neomilium/utophuile/electronics/utophuile_i2c/utophuile_i2c_connector_serigraph.ods

GND | 12V |  | 5V | SDA | GND | SCL | GND
 |  | GND | 12V | K1 | K1
K4 | K4 | GND | 12V |  | K3 | K3 | K2 | K2
 |  |  |  |  |  |  |  |  | K1 = EV Arrivée K2 = EV Retour K3 = Pompe K4 = Réchauffeur
