neomilium/utophuile/electronics/utophuile_i2c/utophuile_i2c_bom.ods

Qty | Value | Device | Parts
1 |  | 78MXXS | IC1
3 |  | DS01 | S1, S2, S3
1 |  | PINHD-1X5 | JP1
6 | 1N4148 | 1N4148 | D1, D2, D3, D4, D5, D6
4 | 2K2 | R-EU_0207/10 | R5, R6, R7, R8
3 | 10K | R-EU_0207/10 | R9, R10, R11
4 | 15K | R-EU_0207/10 | R1, R2, R3, R4
1 | 18 1W | R-EU_0411/15 | R12
1 | 100n | C-EU050-025X075 | C1
1 | 1000µ 10V | CPOL-EUE3.5-10 | C2
1 | 1000µ 20V | CPOL-EUE3.5-10 | C3
4 | BC557 | BC557 | Q1, Q2, Q3, Q4
19 | BORN_VIS2 | BORN_VIS2 | J1, J2, J3, J4, J5, J6, J7, J8, J9, J10, J11, J12, J13, J14, J15, J16, J17, J19, J20
1 | PCF8574P | PCF8574P | U1
4 | RE030005 | RE030005 | K1, K2, K3, K4
