neomilium/utophuile/electronics/avr_mainboard/avr_mainboard_v004_bom.ods

Qty | Value | Device | Parts
1 |  | 10-XX | S1
1 |  | 22-05-7048-04 | J1
1 |  | LED3MM | LED1
2 |  | ML10L | ISP, JTAG
1 |  | PINHD-1X2 | JP2
1 |  | PINHD-1X3 | JP1
3 |  | PINHD-1X4 | ALIM, I2C, SERIE
4 |  | PINHD-1X10 | PA, PB, PC, PD
1 | 10K | R-EU_0207/10 | R2
1 | 16M | CRYTALHC49U-LM | Q1
1 | 24LC256P | 24LC256P | IC2
2 | 33p | C-EU050-024X044 | C1, C2
3 | 100n | C-EU050-025X075 | C3, C4, C5
1 | 220 | R-EU_0207/10 | R1
2 | 32768 | CRYTALTC26H | Q2, Q3
1 | BZW06_5V8 | BZW04XX | D1
1 | CR2032H | CR2032H | G1
1 | DS1307D | DS1307D | IC3
1 | MEGA32-P | MEGA32-P | IC1
