neomilium/utophuile/electronics/utophuile_shield/utophuile_shield_v0_2_bom.ods

Qty | Value | Device | Parts
3 |  | AK500/2 | X1, X2, X3
1 |  | AK500/4 | X4
4 |  | PINHD-1X2_2.54-90° | LED_GREEN, LED_ORANGE, LED_RED, SWITCH
1 |  | PINHD-1X4 | ALIM
2 |  | PINHD-1X4_2.54-90° | BUZZER, UART
4 |  | PINHD-1X10 | PA, PB, PC, PD
2 |  | R-EU_0207/10 | R3, R7
1 | 0 | R-EU_0207/10 | R2
1 | 1K5 | R-EU_0207/10 | R1
1 | 2N2222A | 2N2222A | Q1
1 | 15K | R-EU_0207/10 | R12
1 | 47K | R-EU_0207/10 | R15
5 | 100K | R-EU_0207/10 | R11, R13, R14, R16, R17
3 | 100K | R-TRIMMT93YB | R8, R9, R10
2 | 100n | C-EU050-025X075 | C3, C4
3 | 150 | R-EU_0207/10 | R4, R5, R6
1 | 220µ | CPOL-EUE3.5-10 | C2
1 | 470µ | CPOL-EUE3.5-10 | C1
2 | BZW06_5V8 | BZW04XX | D1, D2
1 | LM324N | LM324N | IC1
