neomilium/utophuile/electronics/utophuile_i2c/utophuile_i2c_brd.pdf

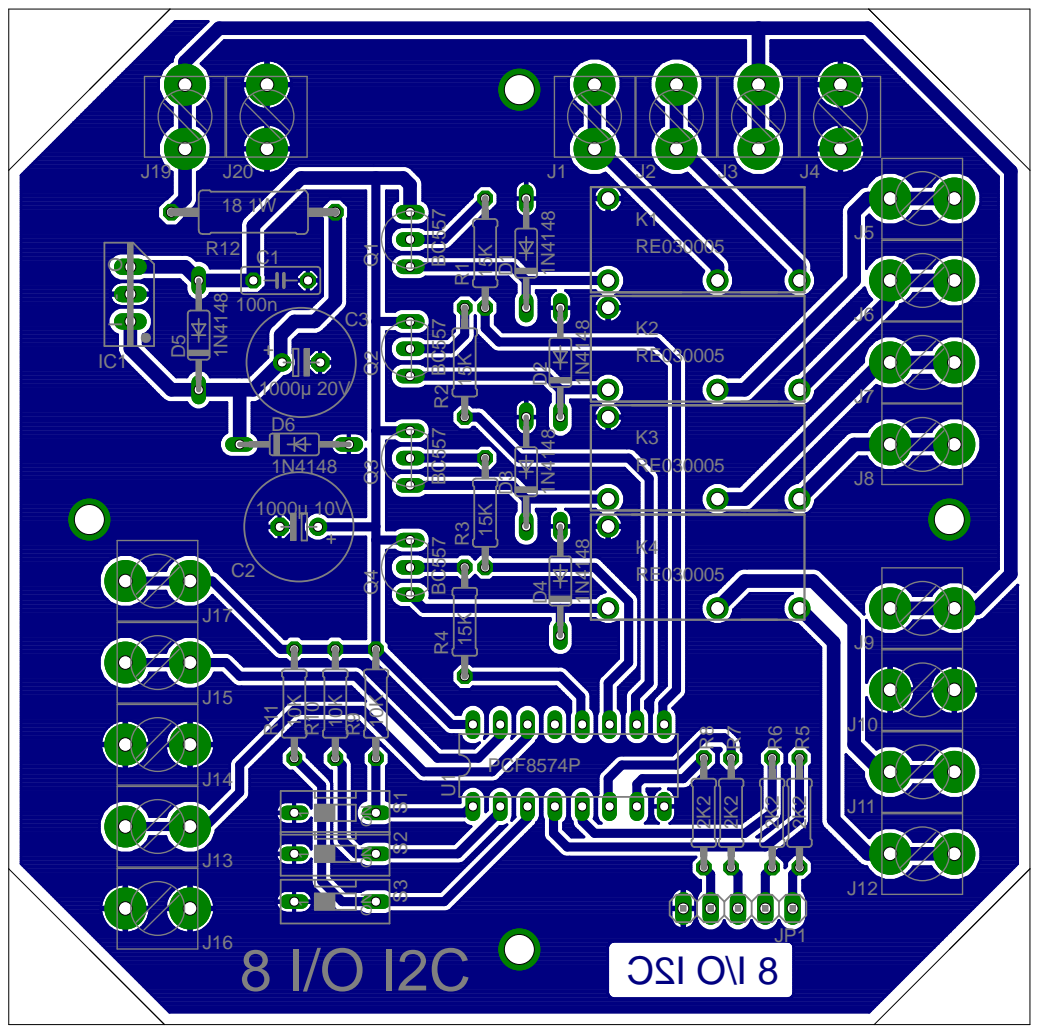
[picture p1: page 1]
