neomilium/utophuile/electronics/utophuile_i2c/utophuile_i2c_brd_bottom.pdf

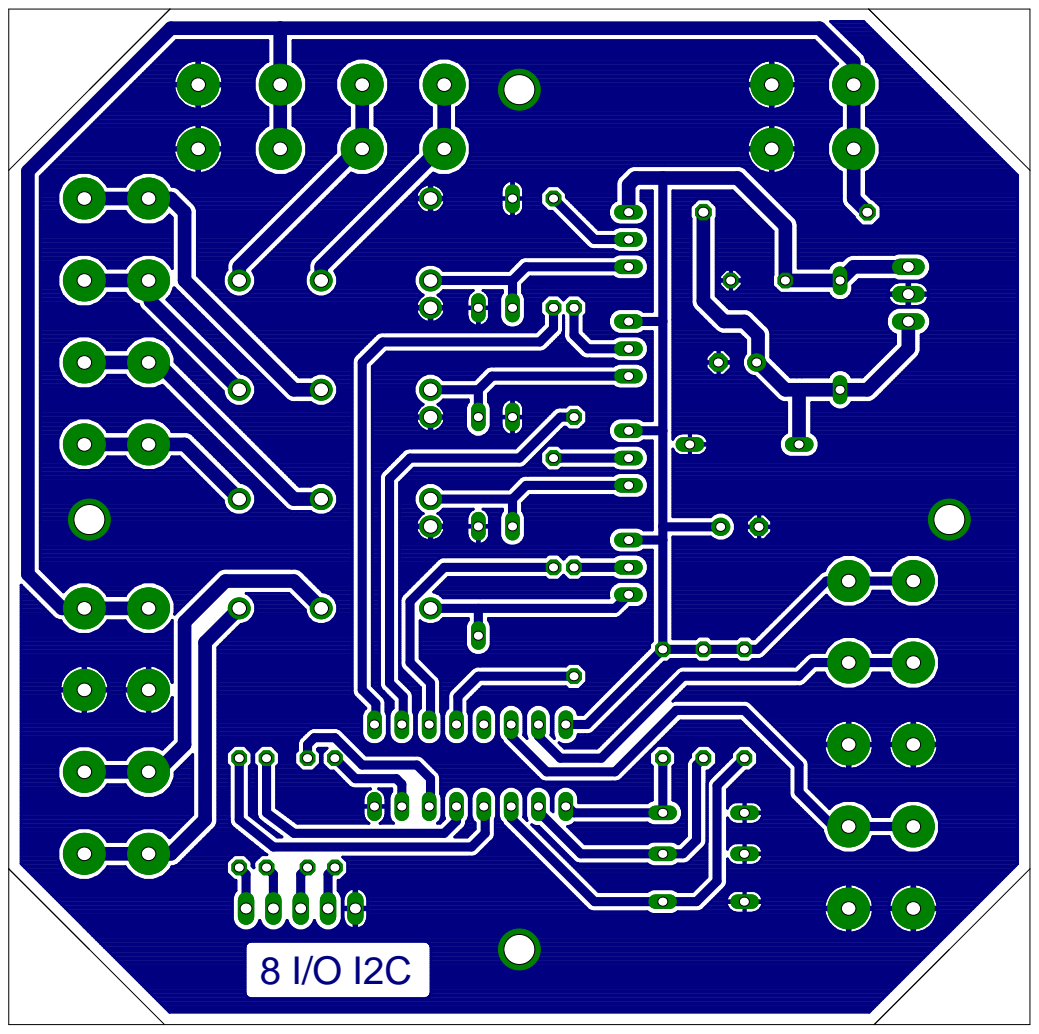
[picture p2: page 1]
