neomilium/utophuile/electronics/utophuile_i2c/utophuile_i2c_brd_implant.pdf

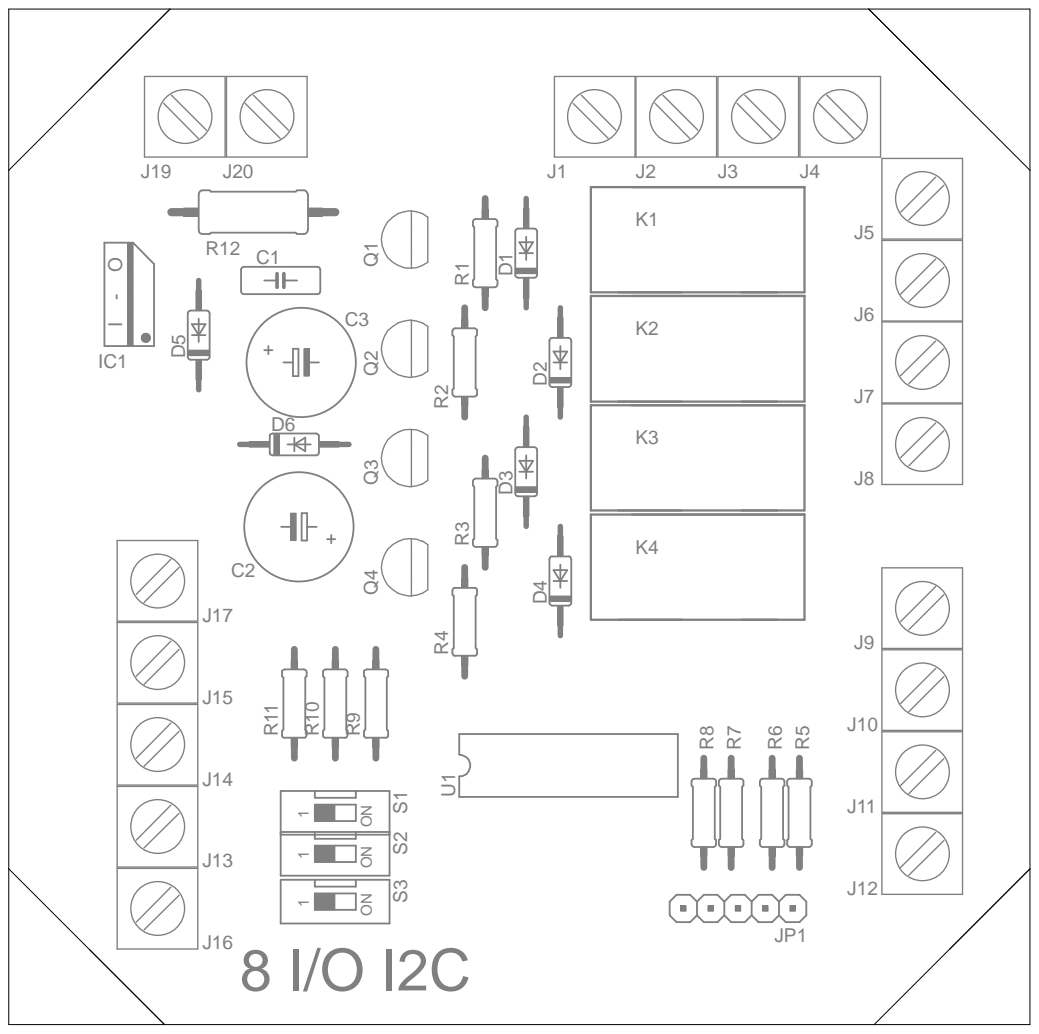
[picture p3: page 1]
