neomilium/utophuile/electronics/utophuile_i2c/utophuile_i2c_sch.pdf

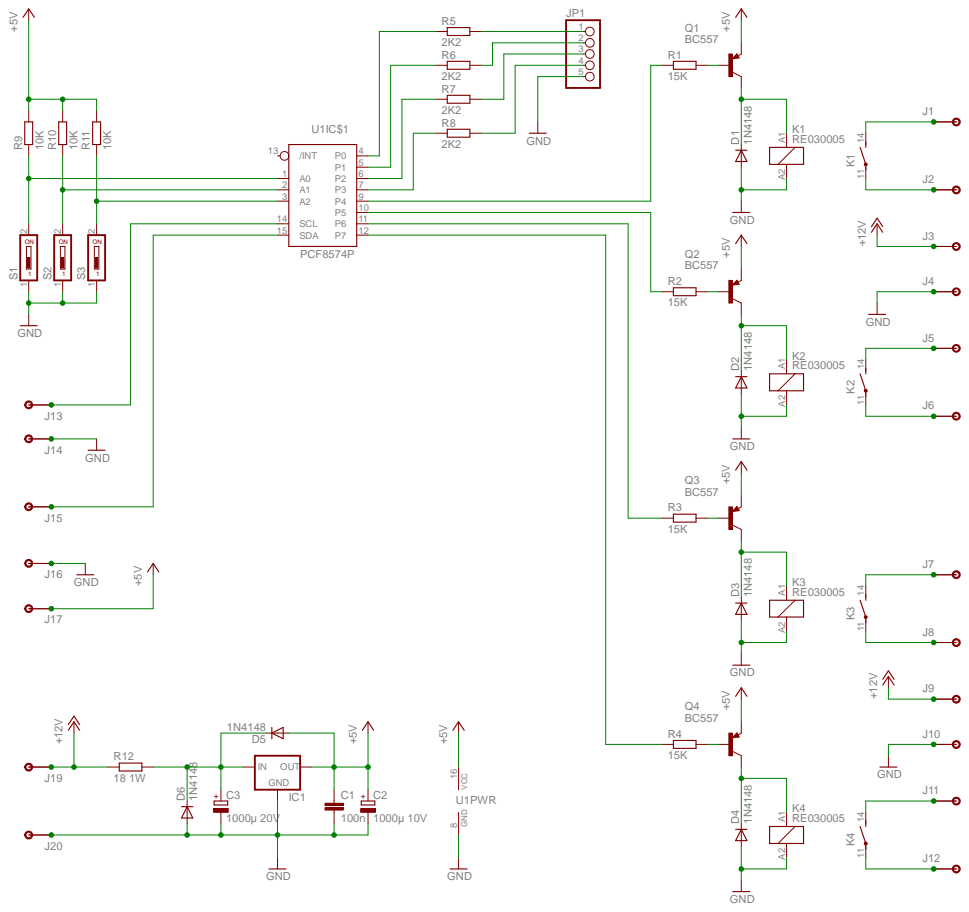
[picture p4: page 1]
