neomilium/utophuile/electronics/utophuile_shield/utophuile_shield_v0_2.sch.pdf

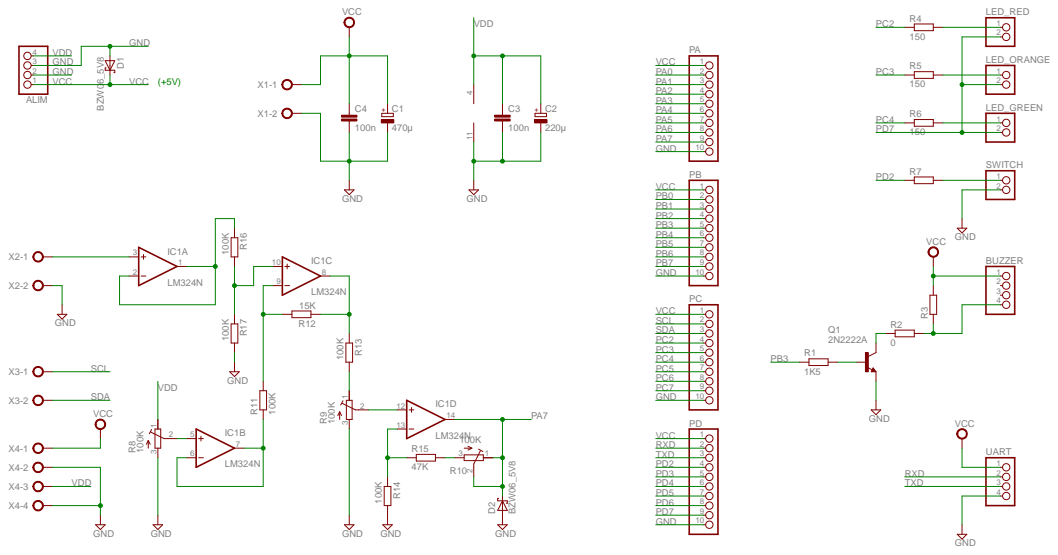
[picture p5: page 1]
