neomilium/utophuile/electronics/utophuile_shield/utophuile_shield_v0_2_brd.pdf

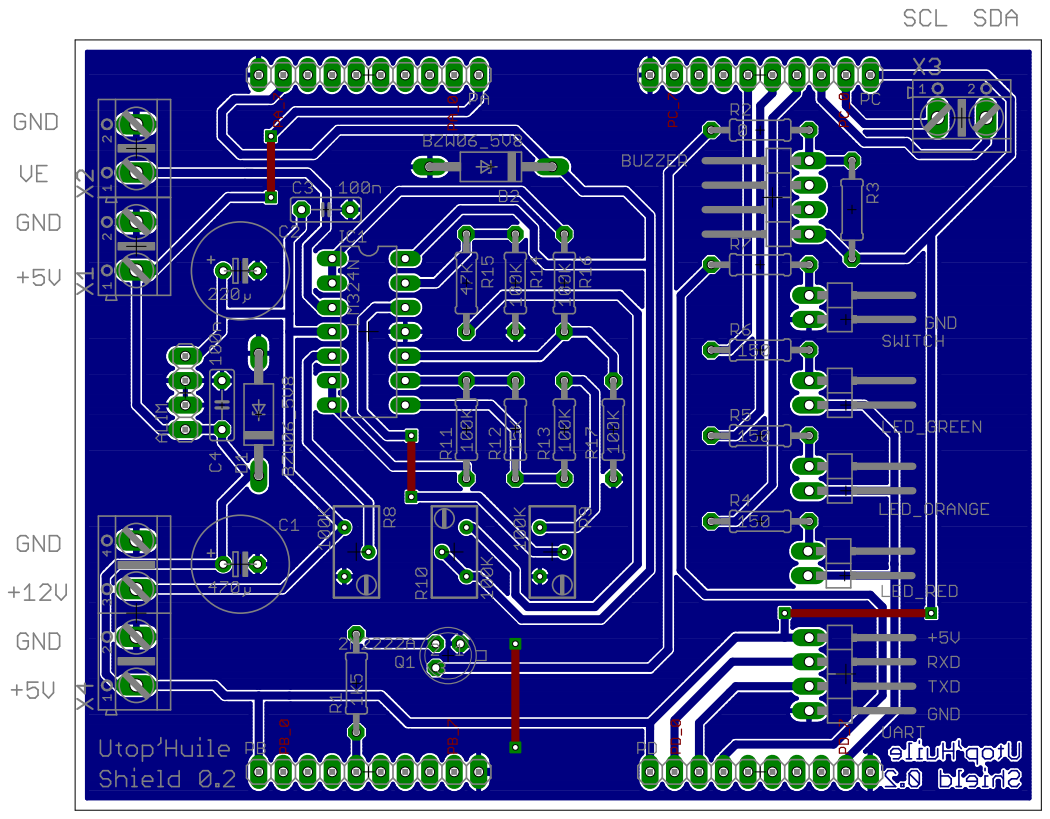
[picture p6: page 1]
