neomilium/utophuile/electronics/utophuile_shield/utophuile_shield_v0_2_brd_bottom.pdf

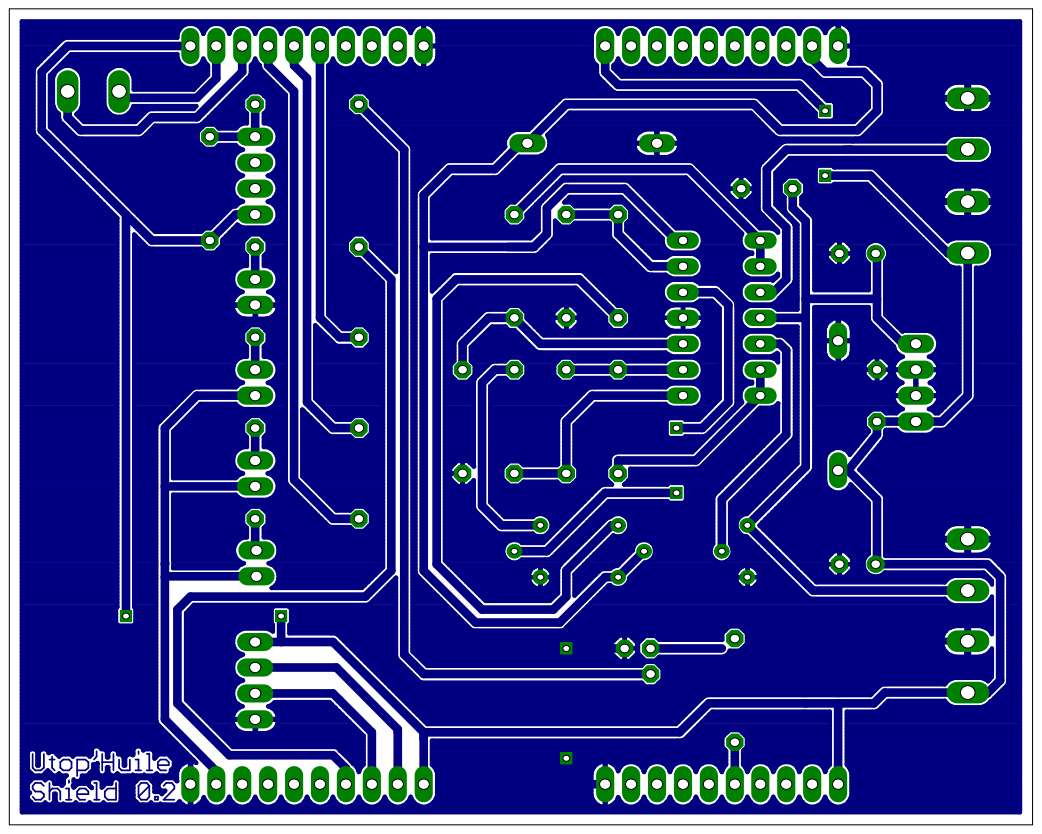
[picture p7: page 1]
