neomilium/utophuile/electronics/utophuile_shield/utophuile_shield_v0_2_brd_implant.pdf

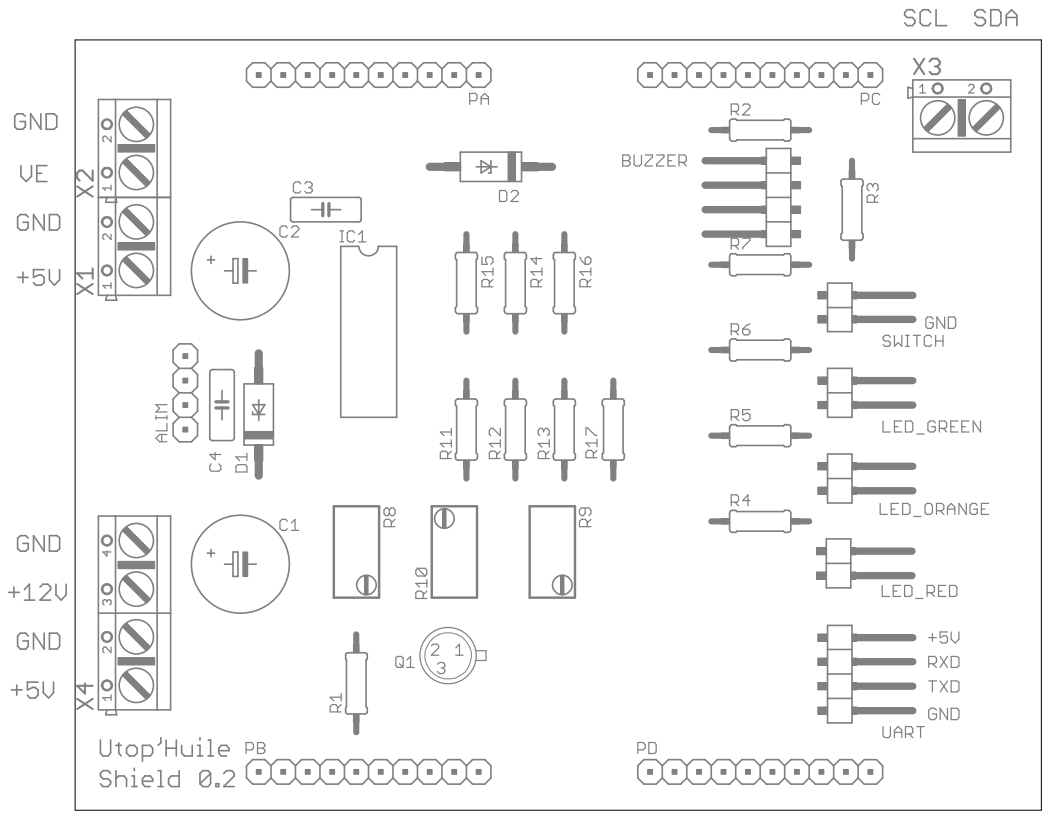
[picture p8: page 1]
