neomilium/utophuile/electronics/utophuile_shield/utophuile_shield_v0_2_brd_top.pdf

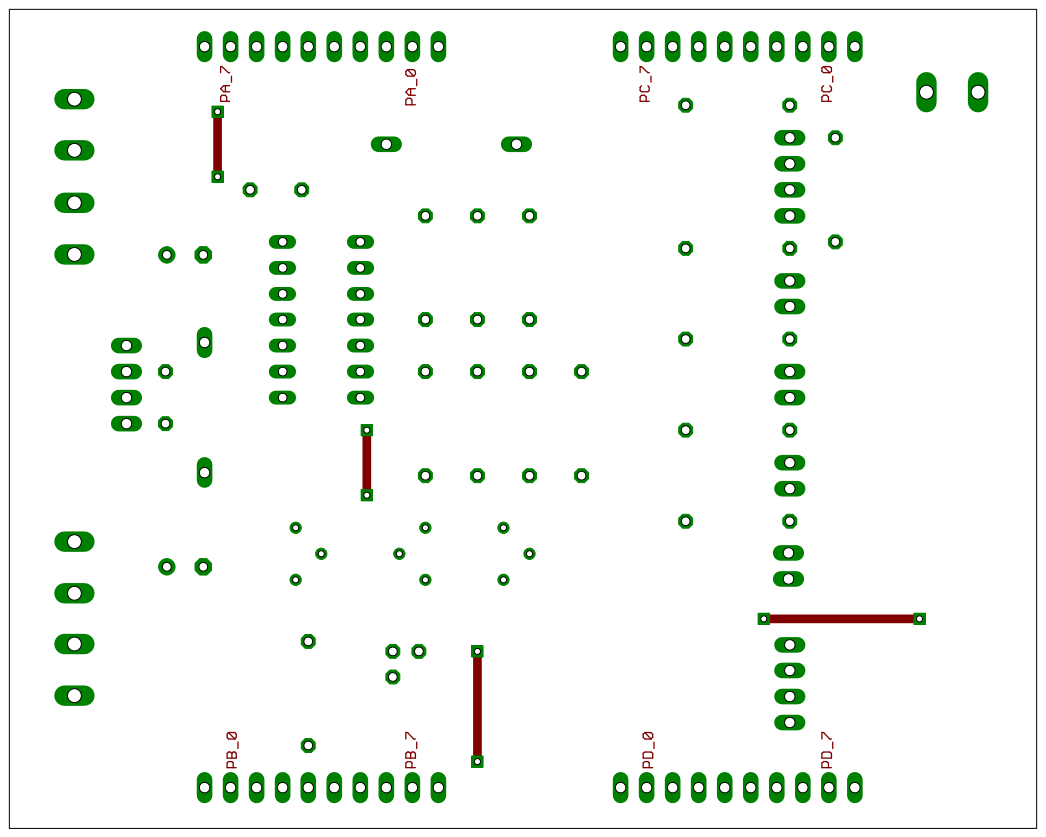
[picture p9: page 1]
