neomilium/utophuile/electronics/avr_mainboard/avr_mainboard_v004_brd.pdf

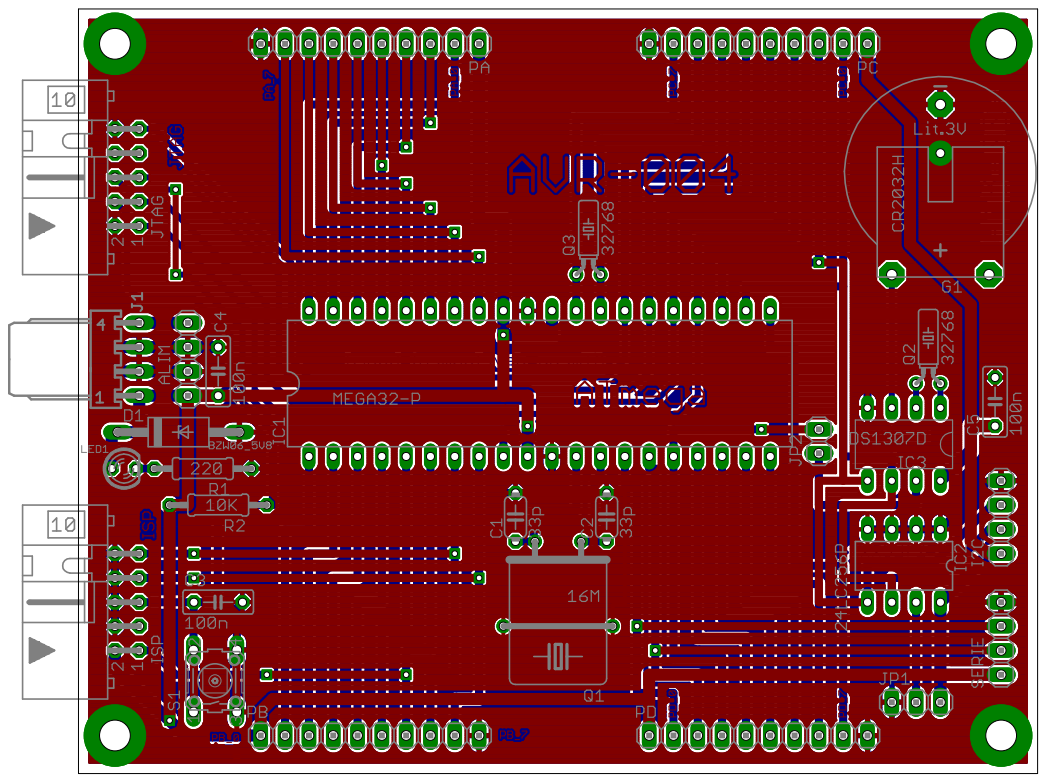
[picture p10: page 1]
