neomilium/utophuile/electronics/avr_mainboard/avr_mainboard_v004_brd_bottom.pdf

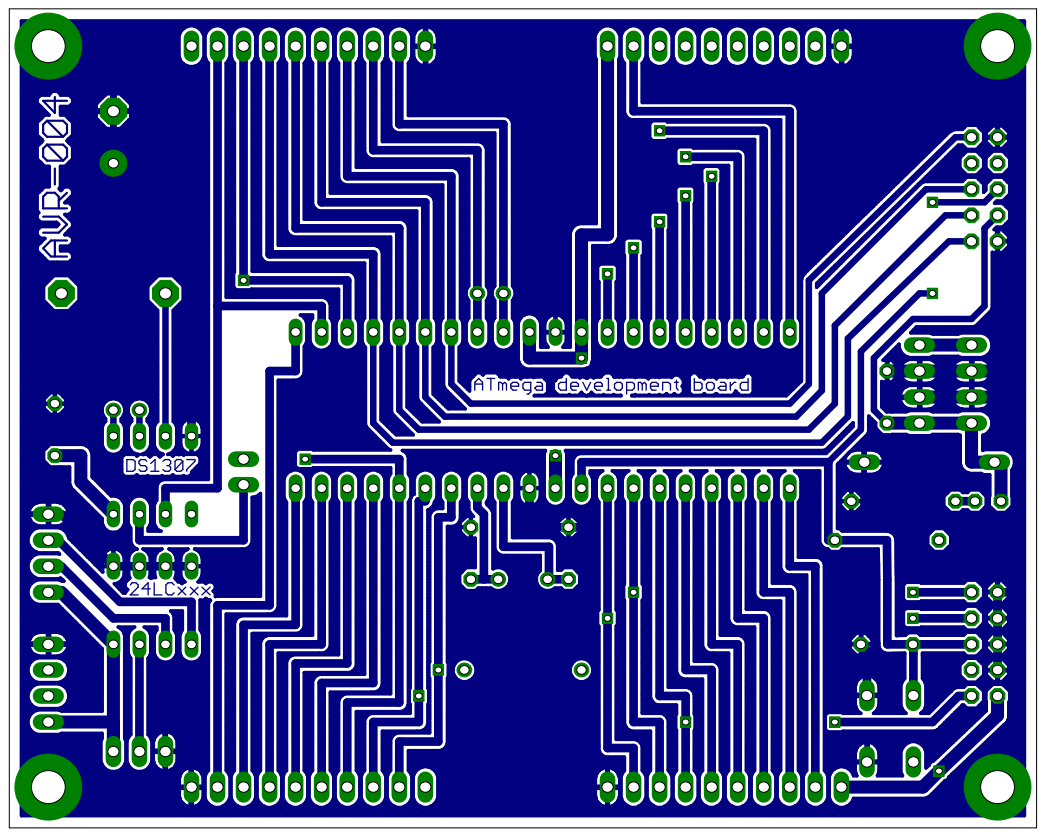
[picture p11: page 1]
