neomilium/utophuile/electronics/avr_mainboard/avr_mainboard_v004_brd_implant.pdf

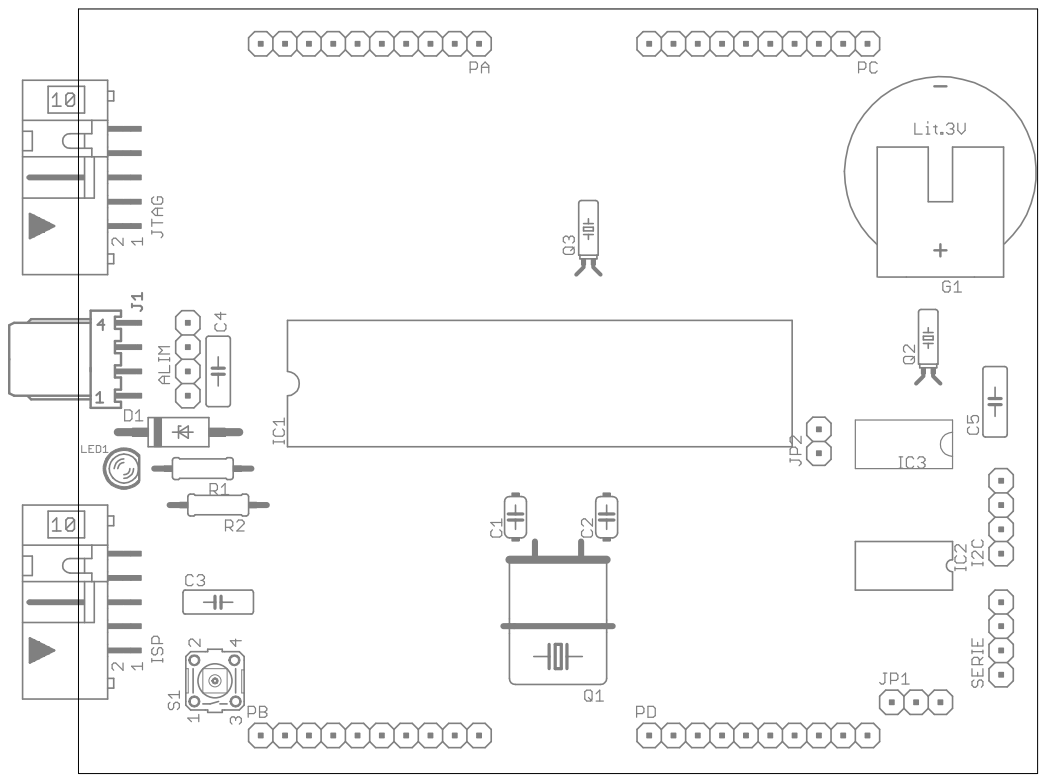
[picture p12: page 1]
