neomilium/utophuile/electronics/avr_mainboard/avr_mainboard_v004_brd_top.pdf

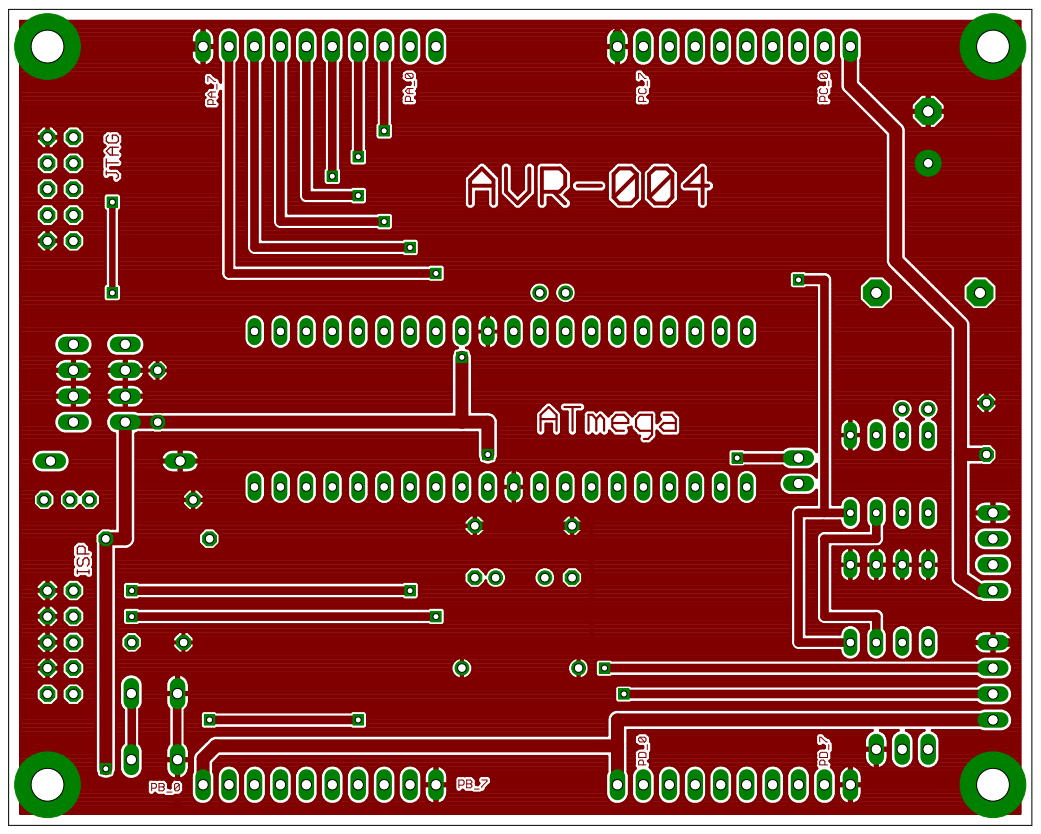
[picture p13: page 1]
