neomilium/utophuile/electronics/avr_mainboard/avr_mainboard_v004_sch.pdf

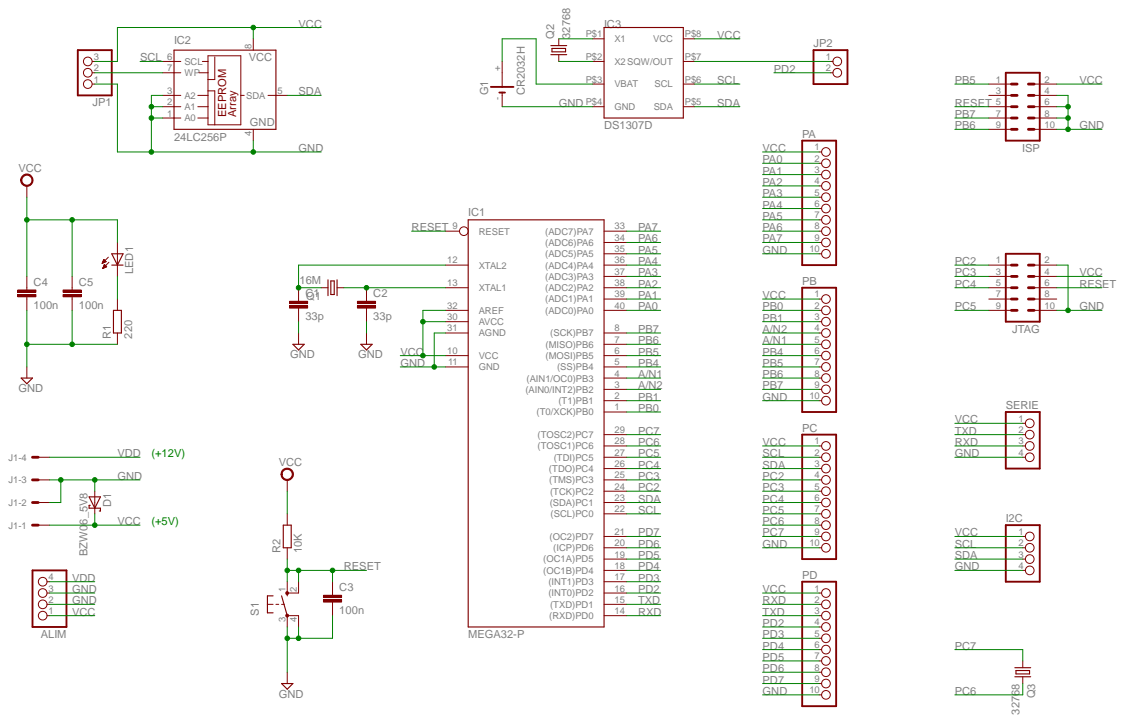
[picture p14: page 1]
