neomilium/utophuile/(commit log)

2010-07-25 LEDs and RBG pins changed.
2010-07-25 Software fix for hardware problem: ADC from temperature gauge is not stable, software now smooths the returned value.
    [utophuile.c]
2010-07-25 Import datasheet for remote 8-bit I/O expander for I2C bus (PCF8574).
2010-08-08 Import some electronics: AVR mainboard (Schematic, Board, BOM)
    [avr_mainboard_v004.brd, avr_mainboard_v004.sch, avr_mainboard_v004_bom.ods]
2010-08-08 Minor repo clean up.
    [avr_mainboard_v004.brd, avr_mainboard_v004.sch, avr_mainboard_v004_bom.ods]
2010-08-08 Import some electronics: UtopHuile Shield (Schematic, Board)
    [utophuile_shield_v0_2.brd, utophuile_shield_v0_2.sch]
2010-08-08 Oops: avr_mainboard_v004_bom.ods is not BOM for AVR mainboard but for the shield.
    [utophuile_shield_v0_2_bom.ods]
2010-08-08 Import BOM for AVR mainboard (really :) ).
    [avr_mainboard_v004_bom.ods]
2010-08-08 Import some electronics: UtopHuile I2C I/O board (Schematic, Board, BOM)
    [utophuile_i2c.brd, utophuile_i2c.sch, utophuile_i2c_bom.ods]
2010-08-08 Import the document used to make connector labels for power board (utophuile_i2c).
    [utophuile_i2c_connector_serigraph.ods]
2013-05-16 Reduce minimal temperature to 60°c
    This commit does fit a special need, please care about your design:
    /!\ 60°C should be enough for indirect-injection engines but not recommended for direct-injection engines, specially high-pressured direct-injection types (ie. almost all cars from ~2005)
2013-07-14 UART: clean up files and set baud rate to 38400
2013-07-14 Arduino: preliminary steps to port utophuile to Arduino hardware
    Makefile have been ajusted to work with Arduino hardware.
    Note: flash is done throught AVRISP MKII programmer.
    Some untested changes to make it compile:
    - adc.c
    - beep.c
    - buttons.c
    - leds.c
    Gauge with RGB is no more a part of utophuile, so rgb.* have been removed.
    Affected files are:
    - utophuile.c
    - rgb.*
    Relay + TWI have been upgraded but do not have been tested with PCF, nevertheless relay connection status detect the missing PCF.
    Affected files are:
    - relay.*
    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
    [beep.c, buttons.c, leds.c, relay.c, relay.h, scheduler.c, shell.c]
2013-07-14 Beep: upgrade beep code to work on new hardware (Arduino)
    * Use a new prescaler as running frequency have changed (8 -> 16 Mhz)
    * Adjust notes fq using http://www.phy.mtu.edu/~suits/notefreqs.html
2013-07-14 Remove internal ADC usage
2013-07-14 Relay: Use generic twi_connection_state struct
2013-07-14 TWI: add a comment to ease Arduino pins location
2013-07-14 TWI: ease debuging with different error code
    [twi.c]
2013-07-14 Buttons: use #defines instead of hardcoded ports
2013-07-14 Leds: code clean up
    Use #define instead of hardcoded ports/pins
    Add comment
    Add Arduino pins
2013-07-14 UtopHuile: re-enable buttons and leds
2013-07-14 Temperature: new way to acquire temp (ie. ADS1115 connected to PT100 dedicated-board)
2013-07-14 UtopHuile: add temperature to 'status' command
2013-07-14 UtopHuile: add pinouts text file to ease Arduino connection
2013-07-14 UtopHuile: add relay mode (commands and feedback) to 'status' command output
2013-09-16 Button: add missing include
    [buttons.c]
2013-09-23 Clean code and its output
    * Remove some commented dead code
    * Remove or comment-out debug printf
    * Disable report mode at reset
    [ads1115.c, buttons.c, leds.c, utophuile.c]
2013-09-23 Fix 'fake temp' command
    * Fix integer formating using printf/scanf
    * Fix command string
    [utophuile.c]
2013-09-23 New command 'relay' to manually toogle relay
    * Rename relay_set() to relay_set_mode()
    * New relay_set() function to enable/disable one relay
    * New 'relay' command (e.g. relay VI 1, relay P 0)
